carnegie-mellon-rocket-command/payload-hw27-usli/PRO-PL27-PAYLOAD-ASSEM.SLDASM

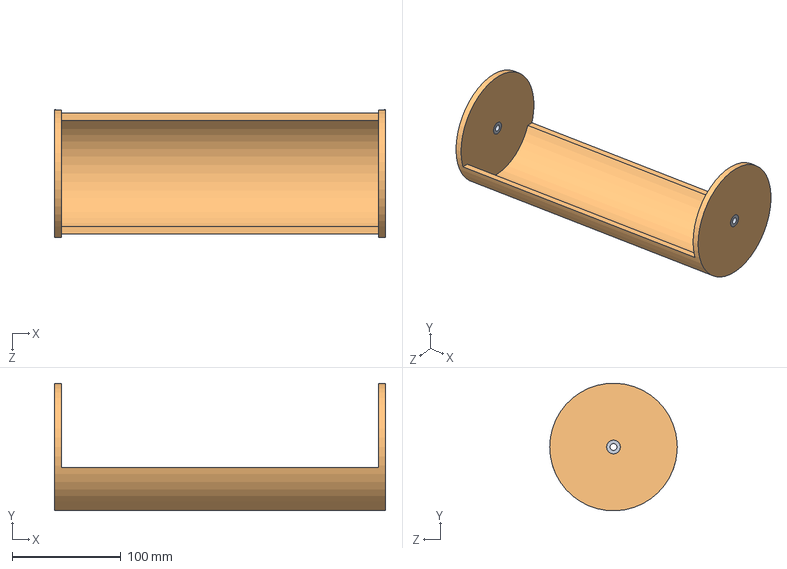
[picture p1: CAD file, 2026-09-14]
PRO-PL27-PAYLOAD-ASSEM.SLDASM
304.8 x 117.4 x 117.5 mm
PRO-PL27-PAYLOAD-CHASSIS
PRO-PL27-BUSHING x 2
