carnegie-mellon-rocket-command/payload-hw27-usli/PRO-PL27-ASSEM.SLDASM

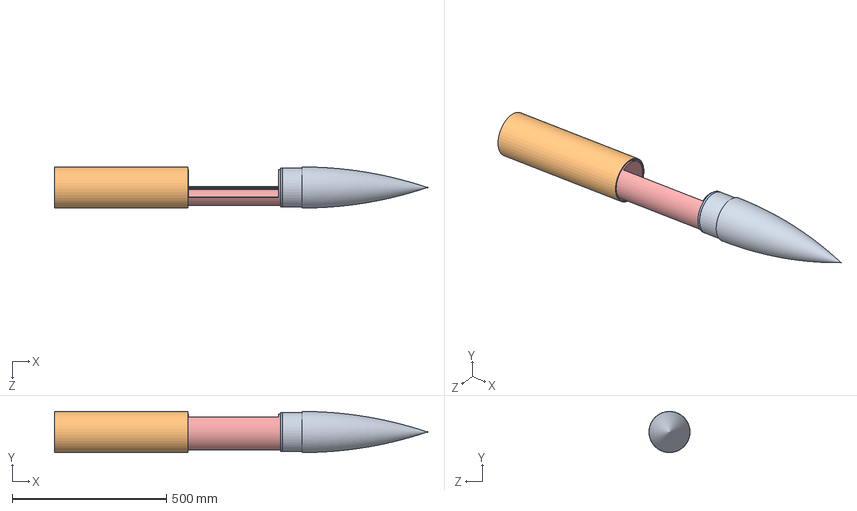
[picture p2: CAD file, 2026-09-14]
PRO-PL27-ASSEM.SLDASM
1208.0 x 133.2 x 133.4 mm
PRO-PL27-AIRFRAME
PRO-PL27-NOSE-CONE
PRO-PL27-FWD-BULKHEAD
PRO-PL27-SERVO-MOTOR
PRO-PL27-LEADSCREW
PRO-PL27-PAYLOAD-CHASSIS
PRO-PL27-BUSHING x 2
PRO-PL27-NC-BULKHEAD
PRO-PL27-PUSH-PLATE-GUIDE
PRO-PL27-PUSH-PLATE
