carnegie-mellon-rocket-command/payload-hw27-usli/PRO-PL27-PISTON.SLDASM

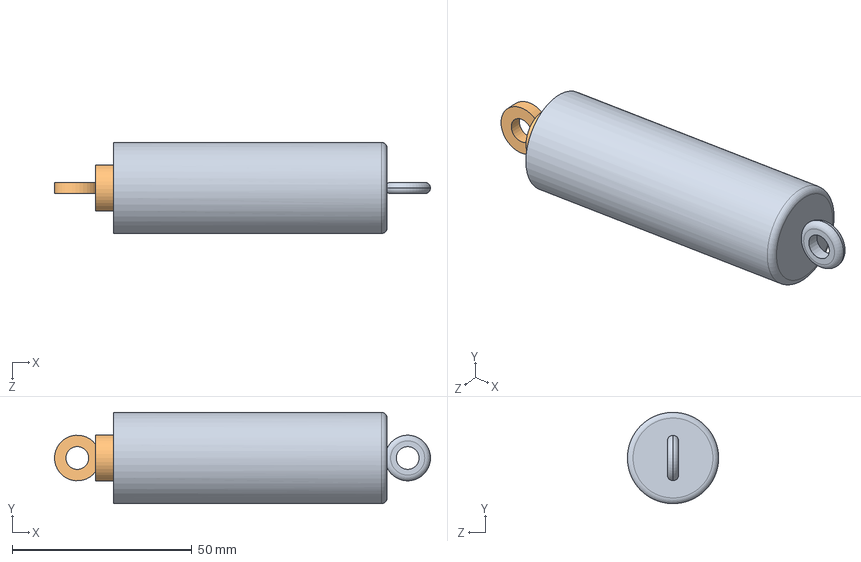
[picture p3: CAD file, 2026-09-14]
PRO-PL27-PISTON.SLDASM
104.6 x 25.4 x 25.4 mm
PRO-PL27-LINK-2
PRO-PL27-LINK-1
