carnegie-mellon-rocket-command/payload-hw27-usli/PRO-PL27-NC-BULKHEAD.SLDPRT

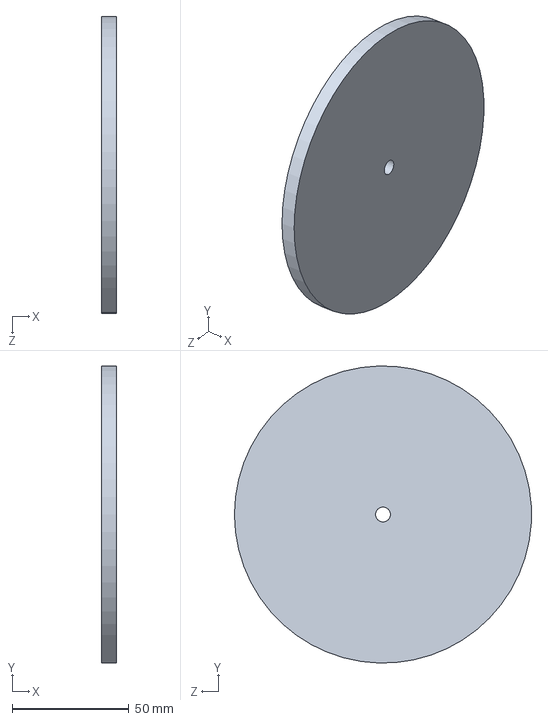
[picture p4: CAD file, 2026-09-14]
PRO-PL27-NC-BULKHEAD.SLDPRT
6.35 x 126.9 x 127.0 mm
