carnegie-mellon-rocket-command/payload-hw27-usli/PRO-PL27-PIN-MOUNT.SLDPRT

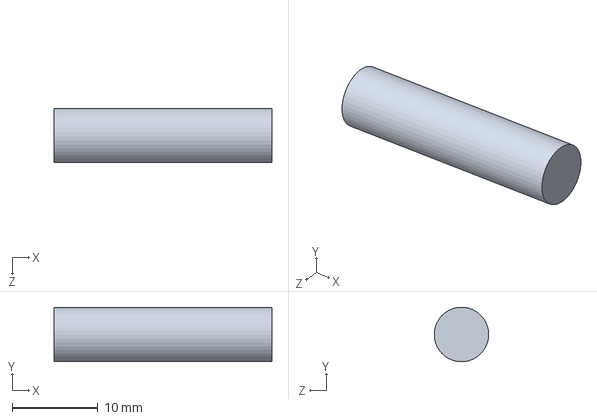
[picture p5: CAD file, 2026-09-14]
PRO-PL27-PIN-MOUNT.SLDPRT
25.4 x 6.35 x 6.35 mm
