carnegie-mellon-rocket-command/payload-hw27-usli/PRO-PL27-LINK-TORSION-SPRING.SLDPRT

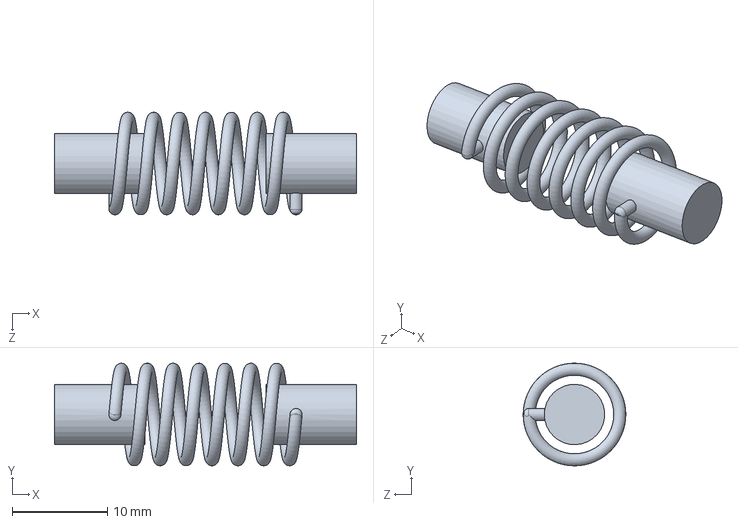
[picture p6: CAD file, 2026-09-14]
PRO-PL27-LINK-TORSION-SPRING.SLDPRT
31.8 x 10.8 x 10.8 mm
