carnegie-mellon-rocket-command/payload-hw27-usli/PRO-PL27-NOSE-CONE.SLDPRT

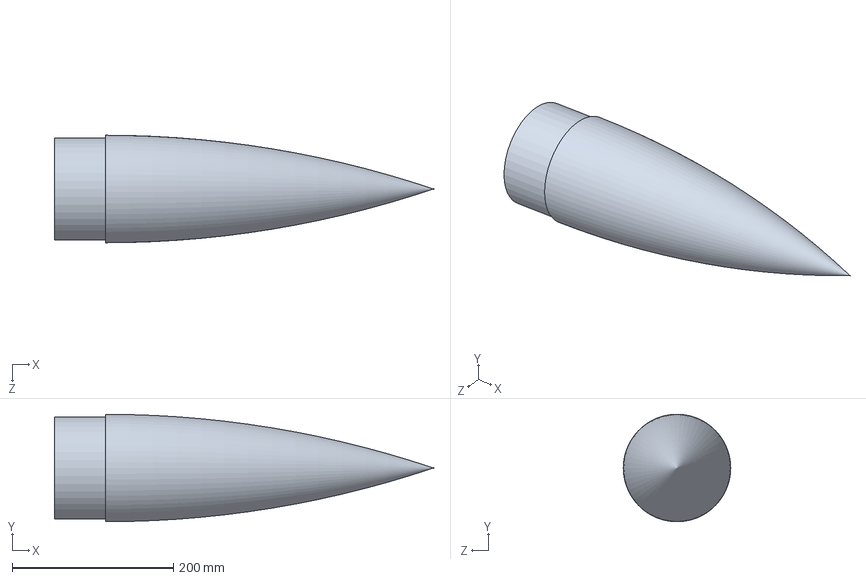
[picture p7: CAD file, 2026-09-14]
PRO-PL27-NOSE-CONE.SLDPRT
469.9 x 133.2 x 133.4 mm
