carnegie-mellon-rocket-command/payload-hw27-usli/PRO-PL27-SERVO-MOTOR.SLDPRT

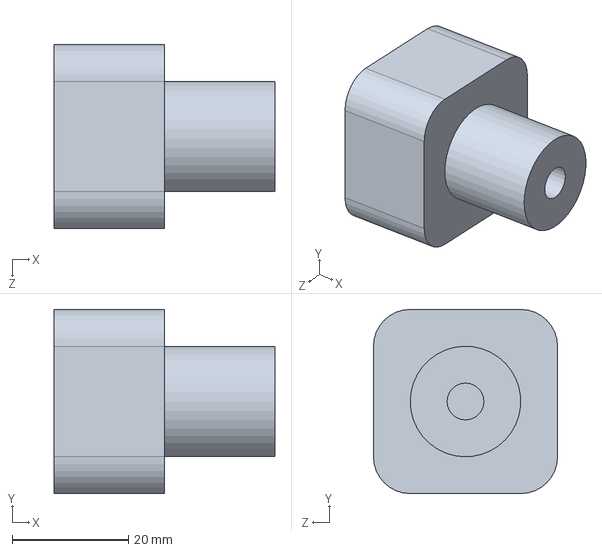
[picture p8: CAD file, 2026-09-14]
PRO-PL27-SERVO-MOTOR.SLDPRT
38.1 x 31.8 x 31.8 mm
