carnegie-mellon-rocket-command/payload-hw27-usli/PRO-PL27-LINK-1.SLDPRT

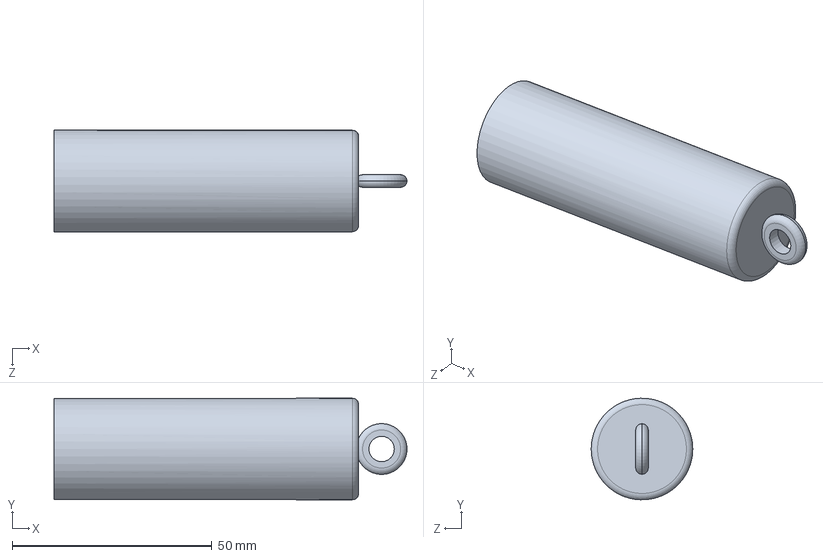
[picture p9: CAD file, 2026-09-14]
PRO-PL27-LINK-1.SLDPRT
88.3 x 25.4 x 25.4 mm
