carnegie-mellon-rocket-command/payload-hw27-usli/PRO-PL27-PUSH-PLATE-GUIDE.SLDPRT

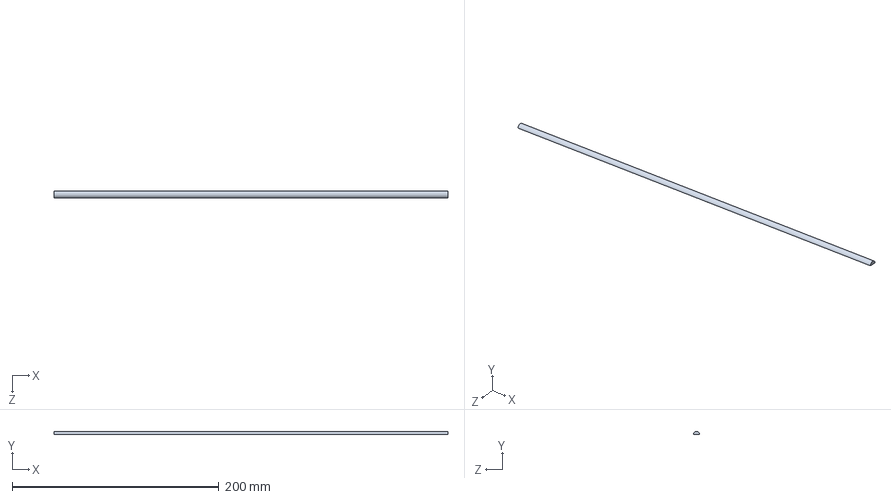
[picture p10: CAD file, 2026-09-14]
PRO-PL27-PUSH-PLATE-GUIDE.SLDPRT
381.0 x 3.18 x 6.35 mm
