carnegie-mellon-rocket-command/payload-hw27-usli/PRO-PL27-LINK-2.SLDPRT

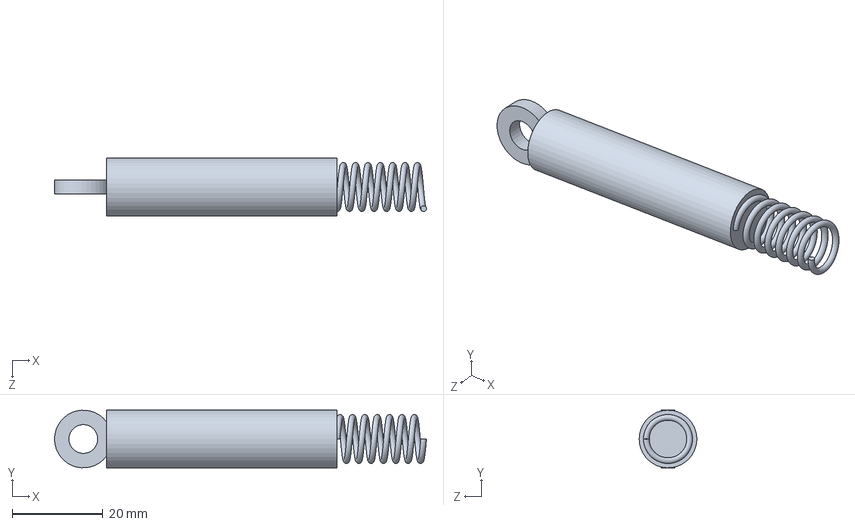
[picture p11: CAD file, 2026-09-14]
PRO-PL27-LINK-2.SLDPRT
81.9 x 12.7 x 12.7 mm
