carnegie-mellon-rocket-command/payload-hw27-usli/PRO-PL27-AIRFRAME.SLDPRT

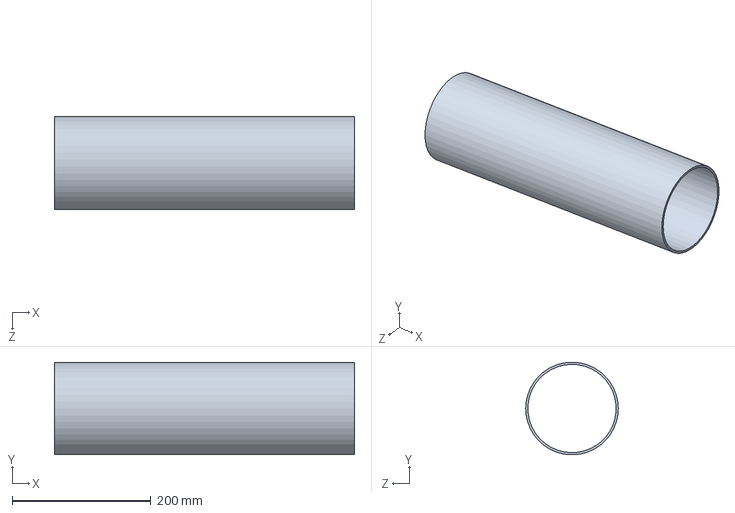
[picture p12: CAD file, 2026-09-14]
PRO-PL27-AIRFRAME.SLDPRT
431.8 x 133.0 x 133.4 mm
