carnegie-mellon-rocket-command/payload-hw27-usli/PRO-PL27-PUSH-PLATE.SLDPRT

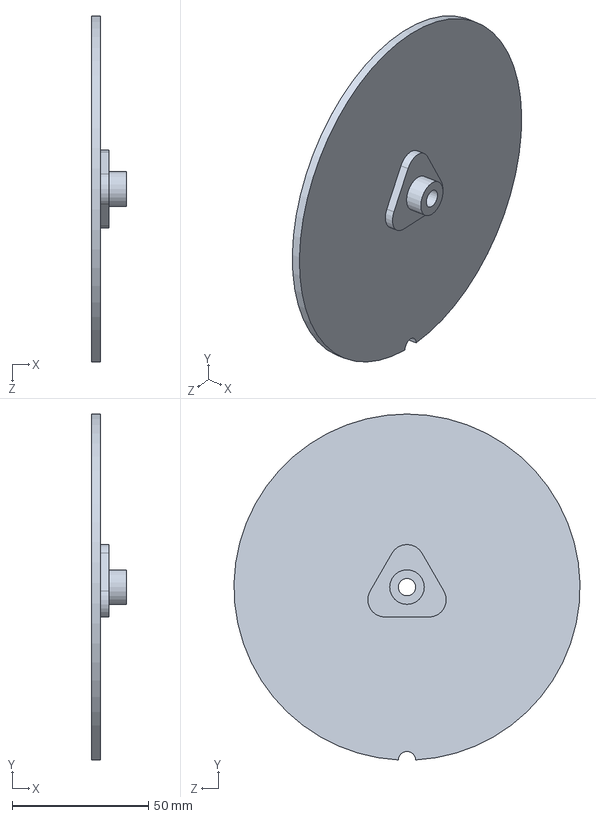
[picture p13: CAD file, 2026-09-14]
PRO-PL27-PUSH-PLATE.SLDPRT
12.7 x 126.9 x 127.0 mm
