carnegie-mellon-rocket-command/payload-hw27-usli/PRO-PL27-BUSHING.SLDPRT

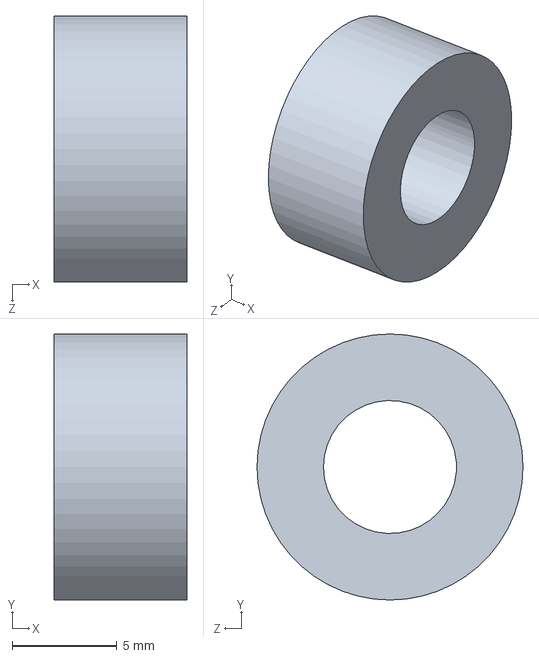
[picture p14: CAD file, 2026-09-14]
PRO-PL27-BUSHING.SLDPRT
6.35 x 12.7 x 12.7 mm
