carnegie-mellon-rocket-command/payload-hw27-usli/PRO-PL27-LEADSCREW.SLDPRT

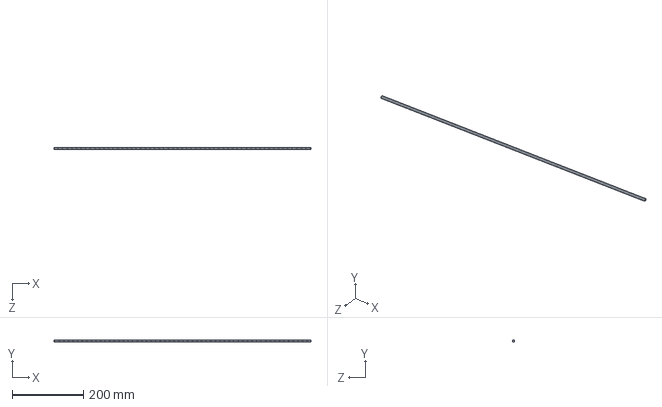
[picture p15: CAD file, 2026-09-14]
PRO-PL27-LEADSCREW.SLDPRT
723.9 x 6.35 x 6.35 mm
