carnegie-mellon-rocket-command/payload-hw27-usli/(list of files, cad)

Other CAD files:
PRO-PL27-PAYLOAD-CHASSIS.SLDPRT
PRO-PL27-FWD-BULKHEAD.SLDPRT
