carnegie-mellon-rocket-command/payload-hw27-usli/Flamingo/flamingo.kicad_pcb

## KiCad design Flamingo/flamingo.kicad_pcb (2026-11-13)

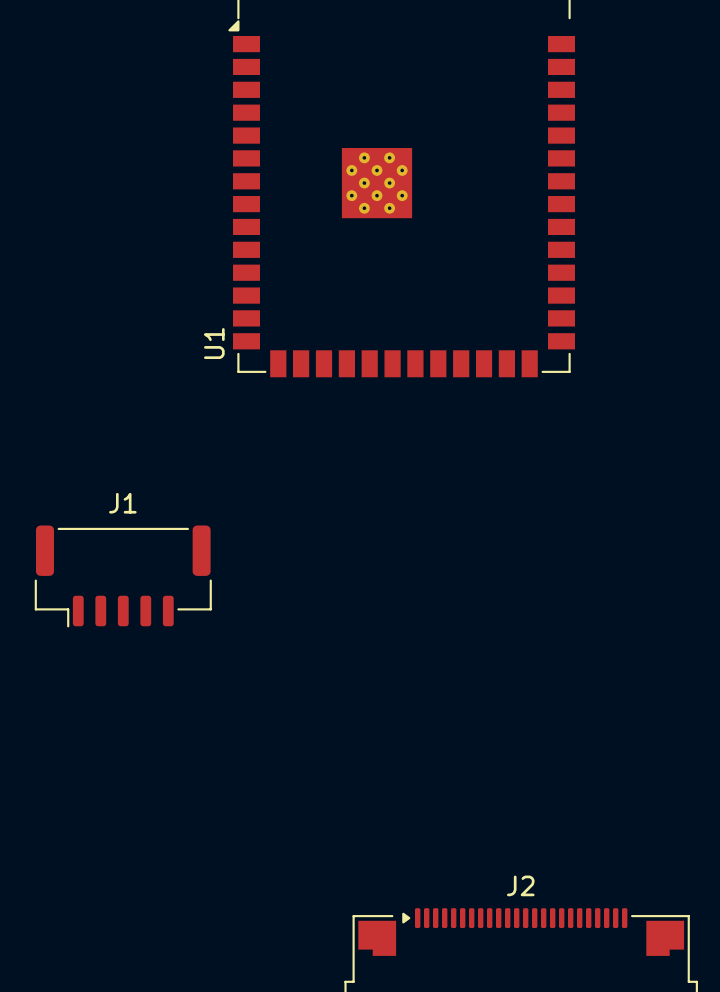
[picture p24: board flamingo.kicad_pcb from above]

Board: 2 copper layers, 3 parts (0 on the bottom side), 19 nets, no tracks yet.

Parts:
J1: STA-M020X; JST_GH_BM05B-GHS-TBT_1x05-1MP_P1.25mm_Vertical
J2: Conn_01x24; Amphenol_F32Q-1A7x1-11024_1x24-1MP_P0.5mm_Horizontal
U1: ESP32-S3-WROOM-1-N16R8; ESP32-S3-WROOM-1

Connections:
/ESP32-S3 core/CAM_HREF: J2.9, U1.18 (IO10)
/ESP32-S3 core/CAM_PCLK: J2.17, U1.16 (IO46)
/ESP32-S3 core/CAM_RST: J2.6, U1.6 (IO6)
/ESP32-S3 core/CAM_SCL: J2.5, U1.5 (IO5)
/ESP32-S3 core/CAM_SDA: J2.3, U1.4 (IO4)
/ESP32-S3 core/CAM_VSYNC: J2.7, U1.17 (IO9)
/ESP32-S3 core/CAM_XCLK: J2.13, U1.21 (IO13)
/ESP32-S3 core/CAM_Y2: J2.19, U1.8 (IO15)
/ESP32-S3 core/CAM_Y3: J2.21, U1.9 (IO16)
/ESP32-S3 core/CAM_Y4: J2.22, U1.10 (IO17)
/ESP32-S3 core/CAM_Y5: J2.20, U1.11 (IO18)
/ESP32-S3 core/CAM_Y6: J2.18, U1.12 (IO8)
/ESP32-S3 core/CAM_Y7: J2.16, U1.13 (USB_D-)
/ESP32-S3 core/CAM_Y8: J2.14, U1.14 (USB_D+)
/ESP32-S3 core/CAM_Y9: J2.12, U1.15 (IO3)
/ESP32-S3 core/LASER_RX: J1.4, U1.38 (IO2)
/ESP32-S3 core/LASER_TX: J1.3, U1.39 (IO1)
GND: J1.1, J2.15
unnamed: U1.1 (GND), U1.40 (GND), U1.41 (GND)
