carnegie-mellon-rocket-command/payload-hw27-usli/(commit log)

2026-08-21 updated schematic based on review
    [bom.csv, camera_pelican.kicad_sch, core_pelican.kicad_sch, ethernet_pelican.kicad_sch, microphone_pelican.kicad_sch, pelican.kicad_sch, power_pelican.kicad_sch, storage_pelican.kicad_sch]
2026-09-14 cad bs
    [PRO-PL27-AIRFRAME.SLDPRT, PRO-PL27-ASSEM.SLDASM, PRO-PL27-BUSHING.SLDPRT, PRO-PL27-FWD-BULKHEAD.SLDPRT, PRO-PL27-LEADSCREW.SLDPRT, PRO-PL27-LINK-1.SLDPRT, PRO-PL27-LINK-2.SLDPRT, PRO-PL27-LINK-TORSION-SPRING.SLDPRT]
2026-09-22 Remove avionics-id27-pelican (wrong repo)
    [27PELICAN-PCB-BACK.DXF, 27PELICAN-PCB-FRONT.DXF, 27PELICAN-PCB.SLDDRW, 27PELICAN-PCB.SLDPRT]
2026-09-27 Update Pelican PCB revision and routing plan
2026-10-13 Update Pelican design libraries and save connector layout concept
2026-10-28 starting schematic work
2026-11-10 updated schematic
2026-11-10 Add laser schematic
2026-11-11 updated camera
2026-11-13 camera schematic with wires to ESP32 GPIO
